Electronics-AndresForero/flapping-butterfly-clip/stl/case_base.stl

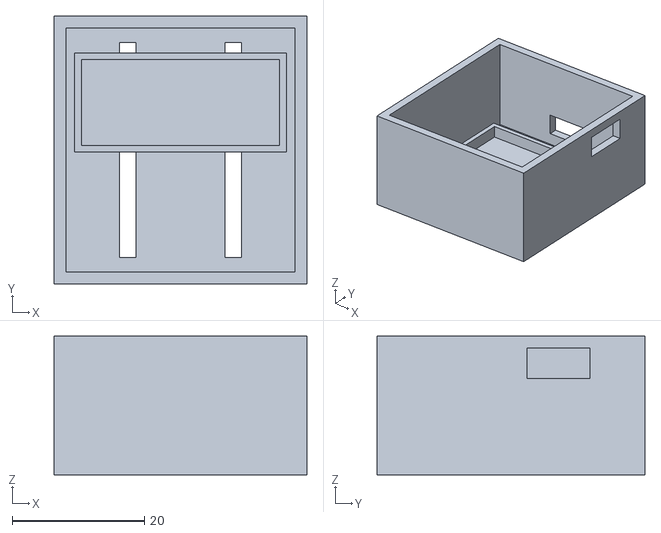
[picture p2: CAD file, 2026-10-15]
stl/case_base.stl
38.2 x 40.5 x 21.0
