Electronics-AndresForero/flapping-butterfly-clip/stl/gear_drive.stl

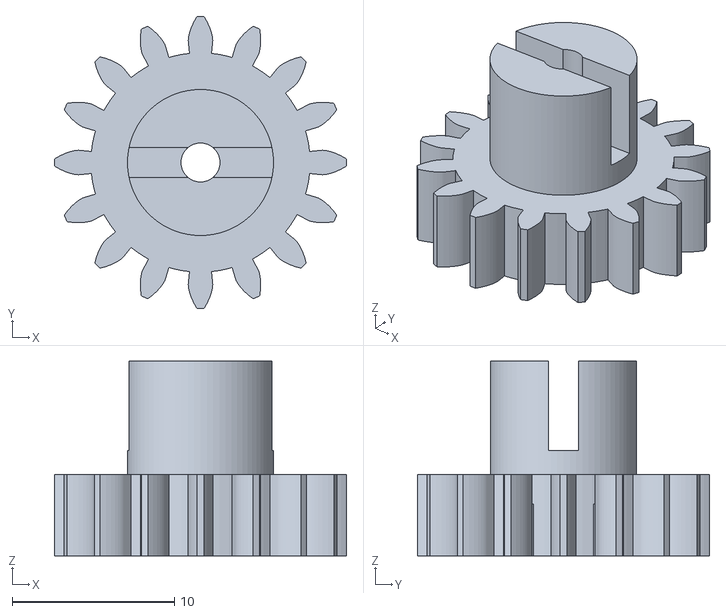
[picture p3: CAD file, 2026-10-15]
stl/gear_drive.stl
18.0 x 18.0 x 12.0
