Electronics-AndresForero/flapping-butterfly-clip/stl/wing_left.stl

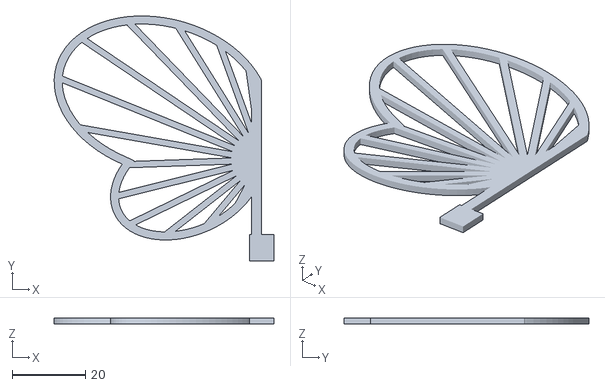
[picture p4: CAD file, 2026-10-15]
stl/wing_left.stl
59.8 x 66.7 x 1.60
