Electronics-AndresForero/flapping-butterfly-clip/stl/gear_idler.stl

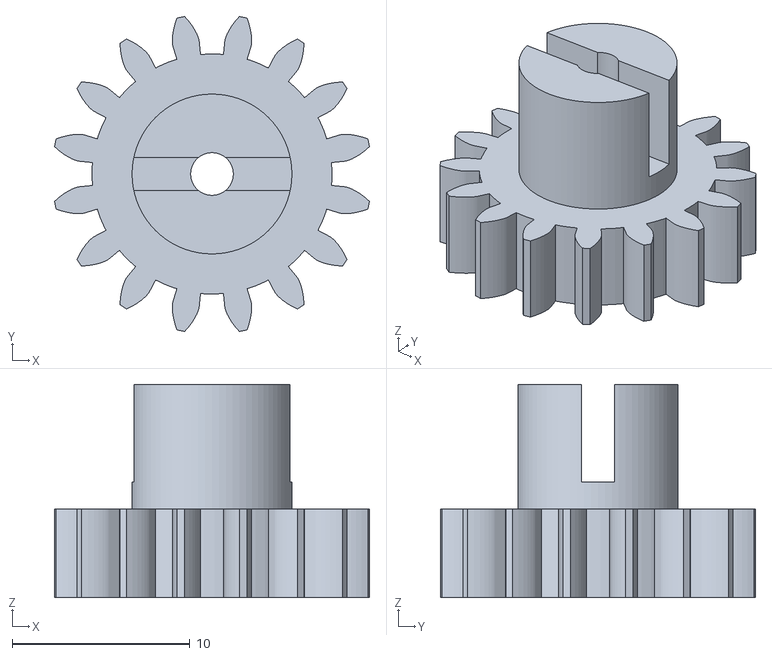
[picture p5: CAD file, 2026-10-15]
stl/gear_idler.stl
17.7 x 17.7 x 12.0
