Electronics-AndresForero/flapping-butterfly-clip/stl/case_lid.stl

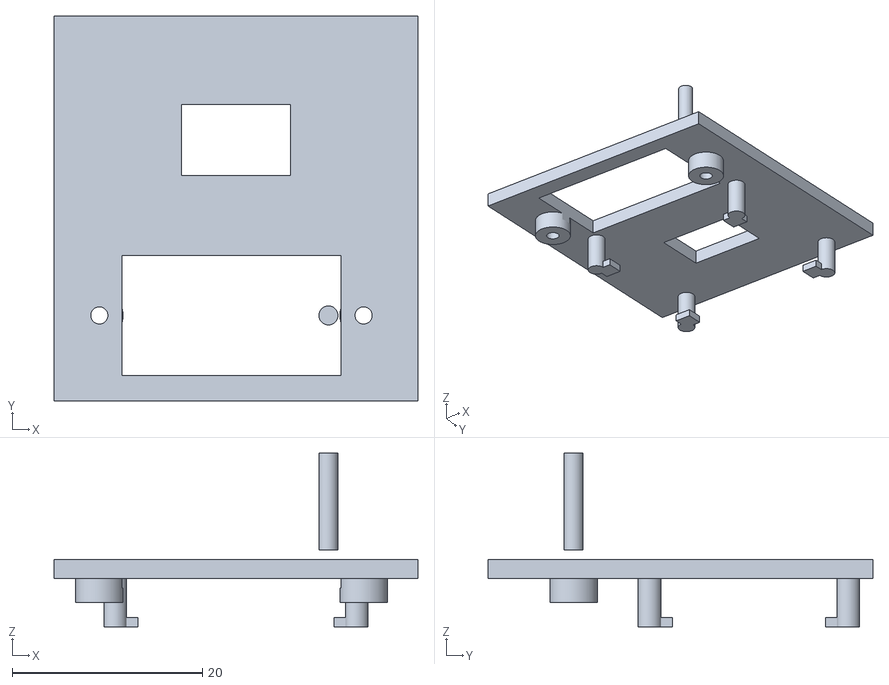
[picture p6: CAD file, 2026-10-15]
stl/case_lid.stl
38.2 x 40.5 x 18.3
