Electronics-AndresForero/flapping-butterfly-clip/(list of files, cad)

Other CAD files:
stl/wing_right.stl
