Electronics-AndresForero/flapping-butterfly-clip/(commit log)

2026-10-15 Initial commit: flapping butterfly clip (ESP32-C3 OLED)
    PlatformIO project with bench and wearable builds, hwcheck tool,
    documented firmware modules, BOM, wiring and LaTeX guide.
2026-10-15 Add original parametric CAD (OpenSCAD) and STLs
    Meshed 1:1 gear pair, lattice wings, tray + lid case. Firmware travel set
    to 90 degrees to match the mechanism. BOM updated.
    [butterfly.scad, case_base.stl, case_lid.stl, gear_drive.stl, gear_idler.stl, wing_left.stl, wing_right.stl]
2026-10-15 Credit the original creator (@resetwithregine) in README, CAD notes and guide
2026-10-15 Guide: full bill of materials, owned vs to-buy, power notes
